nikolak/releaf/hardware/releaf-board.step

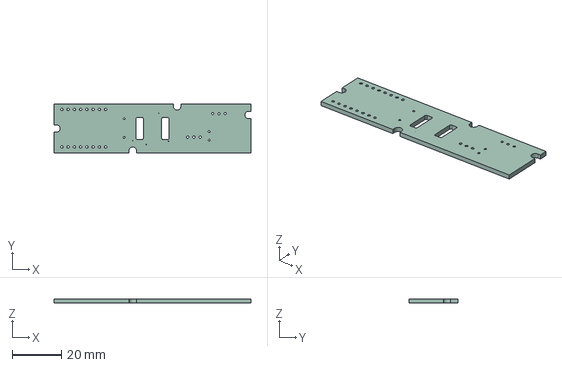
[picture p9: CAD file, 2026-10-25]
hardware/releaf-board.step
80.0 x 20.0 x 1.60 mm
