nikolak/releaf/hardware/shell/releaf-shell-front.step

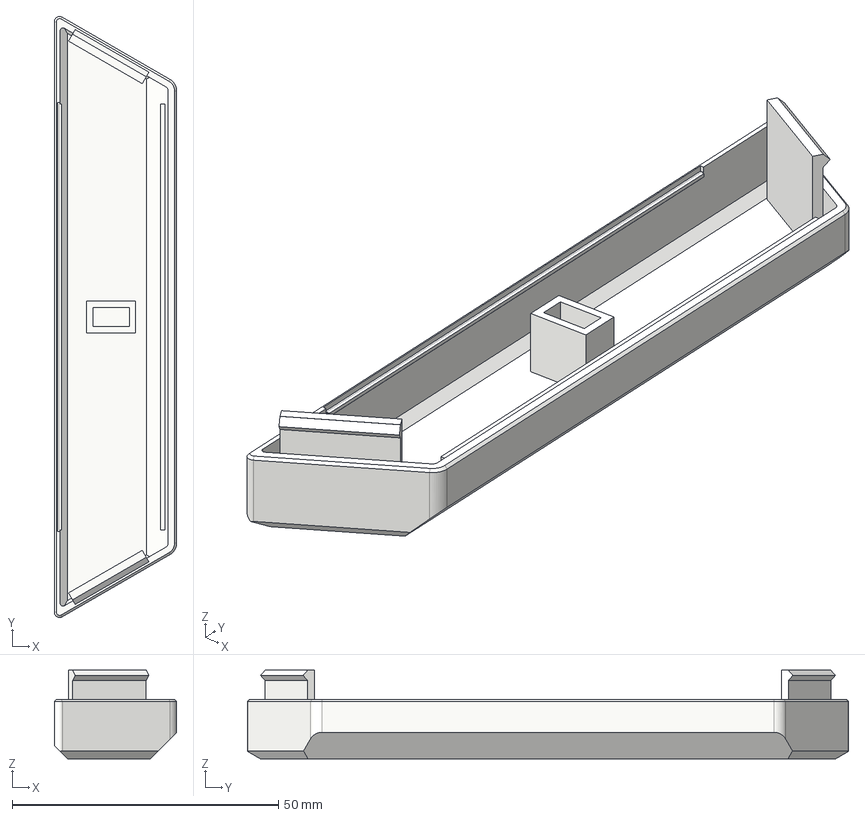
[picture p10: CAD file, 2026-10-25]
hardware/shell/releaf-shell-front.step
23.0 x 113.0 x 16.7 mm
front
logo
