nikolak/releaf/hardware/shell/releaf-shell.3mf

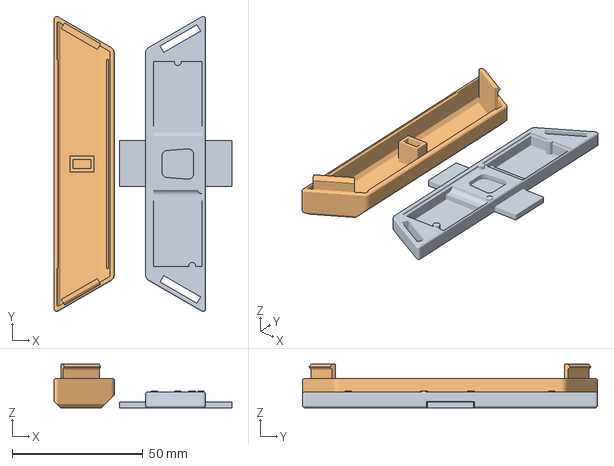
[picture p11: CAD file, 2026-10-25]
hardware/shell/releaf-shell.3mf
68.0 x 113.0 x 16.7 mm
67c6b7a0-d06a-11f1-8d30-0b8ea3a602ae
76e4f4da-d06b-11f1-bde4-e1eee44ac5cf
