nikolak/releaf/hardware/shell/releaf-shell-back.step

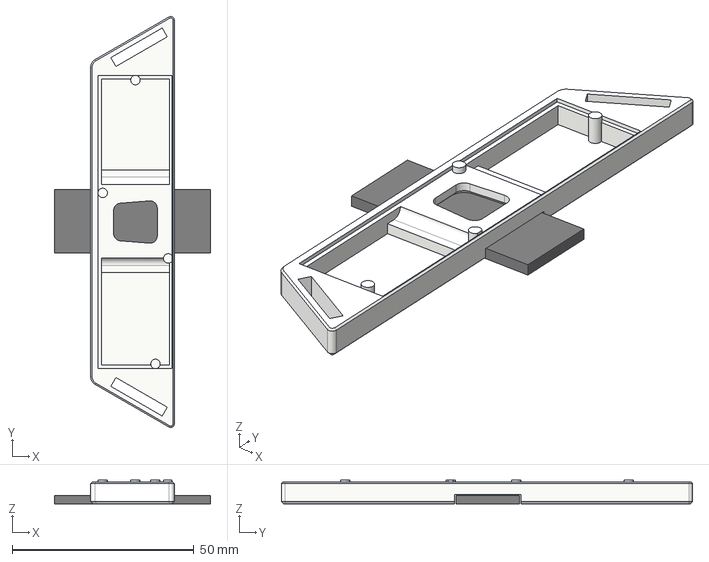
[picture p12: CAD file, 2026-10-25]
hardware/shell/releaf-shell-back.step
43.0 x 113.0 x 6.50 mm
back
support - remove after printing
