nikolak/releaf/hardware/releaf.kicad_pcb

## KiCad design hardware/releaf.kicad_pcb (2026-10-25)

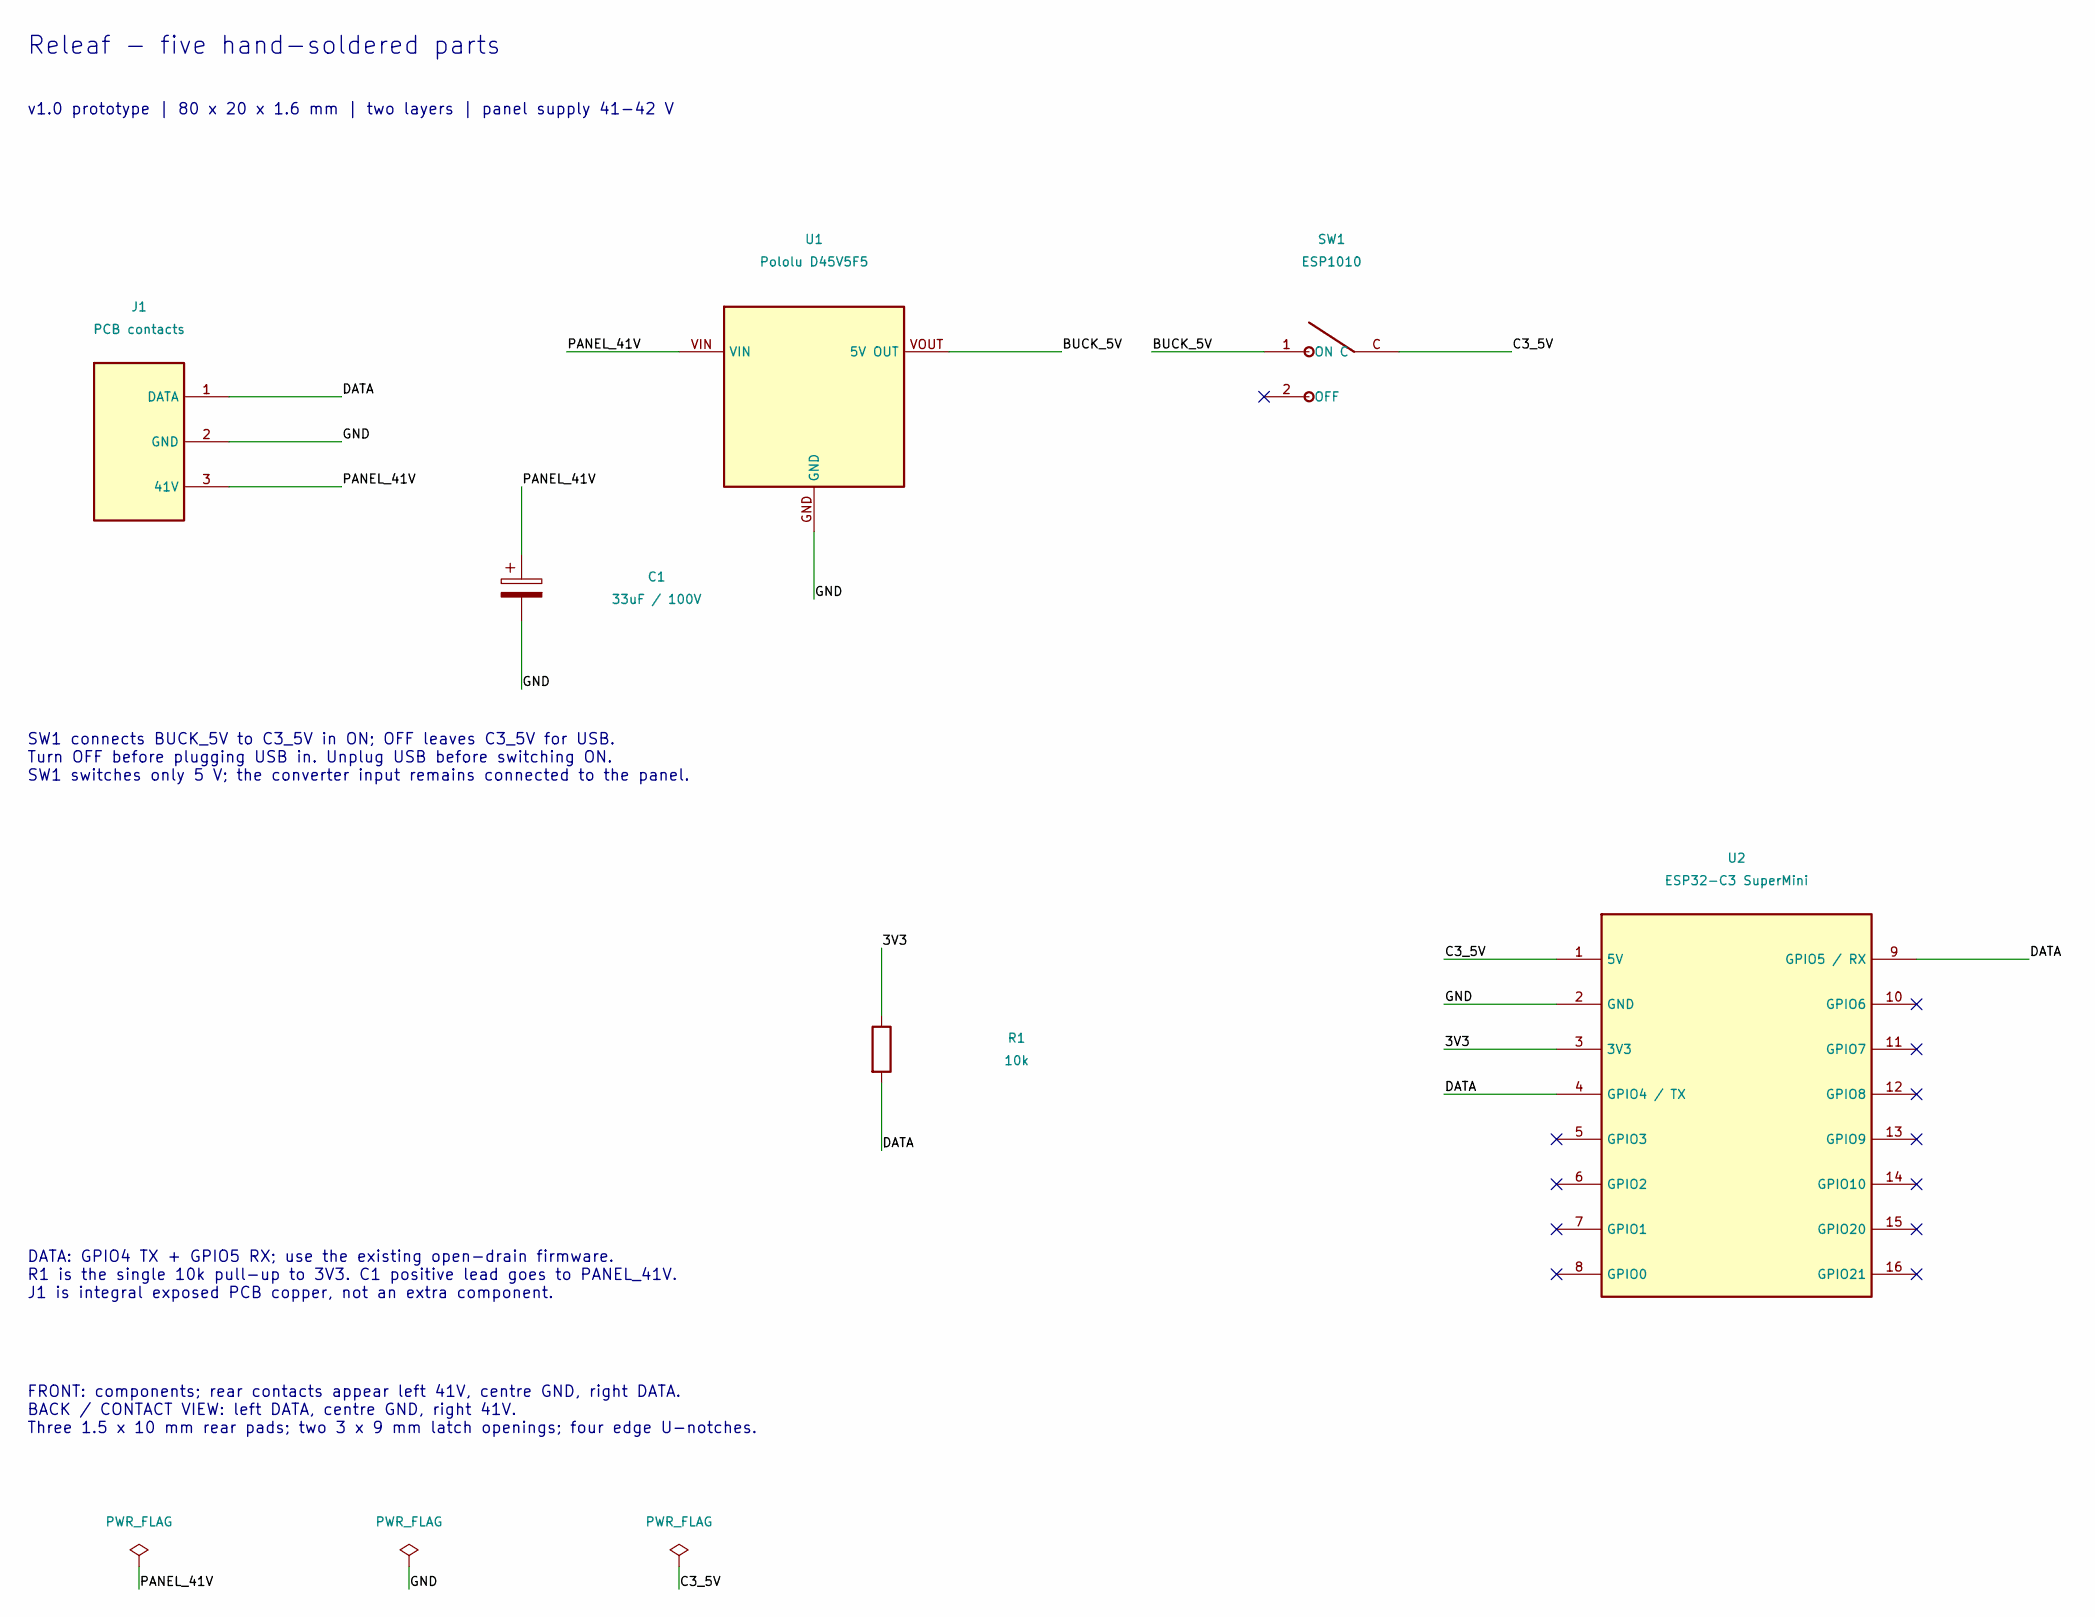
[picture p13: schematic releaf.kicad_sch, Releaf - controller board]

Parts:
C1: 33uF / 100V; CP_Radial_D8_L11.5_Horizontal
J1: PCB contacts; Panel_Contacts
R1: 10k; R_Axial_DIN0207_L6.3mm_D2.5mm_P7.62mm_Horizontal
SW1: ESP1010
U1: Pololu D45V5F5; D45V5F5
U2: ESP32-C3 SuperMini; ESP32_C3_SuperMini

Connections:
/3V3: R1.1, U2.3 (3V3)
/BUCK_5V: SW1.1 (ON), U1.VOUT (5V OUT)
/C3_5V: SW1.C, U2.1 (5V)
/DATA: J1.1 (DATA), R1.2, U2.4 (GPIO4 / TX), U2.9 (GPIO5 / RX)
/GND: C1.2, J1.2 (GND), U1.GND, U2.2 (GND)
/PANEL_41V: C1.1, J1.3 (41V), U1.VIN

Notes on the sheet:
Releaf - five hand-soldered parts
v1.0 prototype | 80 x 20 x 1.6 mm | two layers | panel supply 41-42 V
SW1 connects BUCK_5V to C3_5V in ON; OFF leaves C3_5V for USB. Turn OFF before plugging USB in. Unplug USB before switching ON. SW1 switches only 5 V; the converter input remains connected to the panel.
DATA: GPIO4 TX + GPIO5 RX; use the existing open-drain firmware. R1 is the single 10k pull-up to 3V3. C1 positive lead goes to PANEL_41V. J1 is integral exposed PCB copper, not an extra component.
FRONT: components; rear contacts appear left 41V, centre GND, right DATA. BACK / CONTACT VIEW: left DATA, centre GND, right 41V. Three 1.5 x 10 mm rear pads; two 3 x 9 mm latch openings; four edge U-notches.

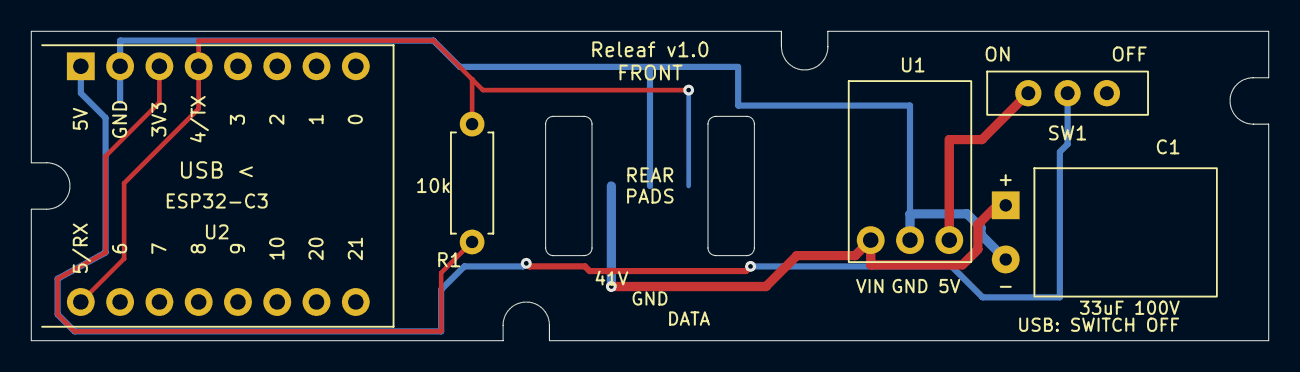
[picture p14: board releaf.kicad_pcb from above]

Board: 2 copper layers, 80.0 x 20.0 mm, 6 parts (1 on the bottom side), 6 nets.
