nikolak/releaf/CHANGELOG.md

# Changelog

## Unreleased

## 1.0.0

- WLED usermod and build configuration for controlling Nanoleaf Shapes with an ESP32-C3 SuperMini.
- Optional controller board with KiCad files and Gerbers for PCB fabrication.
- 3D-printable shell as STEP files and a Bambu Studio project.
- Build script and GitHub releases with firmware for USB installation and WLED updates.
